Serra-Rocketry/ignitor/(commit log)

2026-09-25 feat(pcb): consolida projetos de ignição THT/SMD e move gerbers para hardware/gerbers
    - Adiciona projetos pcbignicao (THT) e pcbignicao_smd completos
    - Adiciona biblioteca compartilhada hardware/kicad/shared/lib
    - Move gerbers do comando para hardware/gerbers/pcbcomando e remove
    fabricação/*.nc, round-tracks-config e gerbers antigos avulsos
    - Versiona BOM/CPL/posição de fabricação (exceções ao *.csv no .gitignore)
    - Ignora *.bak e *.kicad_prl e deixa de rastrear pcbcomando.kicad_prl
    [alimentacao.kicad_sch, bom.csv, expansao.kicad_sch, interface.kicad_sch, jlcpcb-bom.csv, mcu_esp32.kicad_sch, mcu_pico.kicad_sch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]
2026-09-25 docs(pcb): normaliza títulos e revisão do projeto SMD
    - Sufixo (SMD) nos títulos da raiz e das subfolhas
    - Rev 2.0 e data 2026-09-24 alinhados ao README de fabricação
    - Corrige comentário que citava a placa THT
    - Netlist validado: idêntico antes/depois
    [alimentacao.kicad_sch, expansao.kicad_sch, interface.kicad_sch, mcu_esp32.kicad_sch, pcbignicao_smd.kicad_sch, radio_lora.kicad_sch, saida_ignicao_seguranca.kicad_sch]
2026-09-25 docs(pcb): adiciona sufixo (THT) aos títulos do projeto de ignição
    - Sufixo (THT) nos títulos da raiz e das subfolhas
    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
    [alimentacao.kicad_sch, expansao.kicad_sch, interface.kicad_sch, mcu_pico.kicad_sch, pcbignicao.kicad_sch, radio_lora.kicad_sch, saida_ignicao_seguranca.kicad_sch]
2026-09-25 refactor(pcb): hierarquiza o esquema do comando em subfolhas
    - Divide o esquema plano em Alimentacao, MCU_Pico, Radio_LoRa e Interface
    - Itens movidos por bloco, com offset ancorado na grade de 1,27 mm
    - Rev 1.2 / data 2026-09-25 e títulos nas subfolhas
    - Netlist validado: idêntico antes/depois; ERC mantém os mesmos 6 avisos
    [alimentacao.kicad_sch, interface.kicad_sch, mcu_pico.kicad_sch, pcbcomando.kicad_sch, radio_lora.kicad_sch]
2026-09-25 feat(pcb): reduz vias de costura da ignição THT (rev 1.3)
    - Vias GND: 112 -> 43 (total 124 -> 55), espaçamento ~6-8 mm
    - Zonas refeitas; DRC mantém 0 itens desconectados
    - Corrige título do PCB (estava com o título do comando) e sobe rev/data
    - Gerbers, drill e pacote JLCPCB regenerados; README atualizado
    - Netlist revalidado: idêntico antes/depois
    [alimentacao.kicad_sch, expansao.kicad_sch, interface.kicad_sch, mcu_pico.kicad_sch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]
2026-09-25 feat(pcb): reduz vias de costura da ignição SMD (rev 2.1)
    - Vias GND: 388 -> 101 (total 406 -> 119), espaçamento ~6-8 mm
    - 2 vias de ponte amarram as ilhas de cobre perto de J9/J11
    - DRC: 0 itens desconectados (antes 1, o ilhado documentado no README)
    - Corrige título do PCB e sobe rev/data; gerbers e pacote JLCPCB regenerados
    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
    [alimentacao.kicad_sch, expansao.kicad_sch, interface.kicad_sch, mcu_esp32.kicad_sch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]
2026-09-25 fix(pcb): sincroniza paths de folha dos footprints (THT/SMD)
    - Footprints apontavam para "/" ou UUIDs antigos; agora seguem a hierarquia
    - Reduz avisos de paridade (THT 80->76, SMD 82->75)
    - Sem mudança de cobre/serigrafia: gerbers permanecem válidos
    [pcbignicao.kicad_pcb, pcbignicao_smd.kicad_pcb]
2026-09-25 feat(pcb): padroniza pacote de fabricação do comando (rev 1.2)
    - Gerbers com extensão Protel, drill único e job, como as placas de ignição
    - Remove gerbers antigos (.gbr e drills NPTH/PTH separados) e regenera o zip
    - Cria hardware/gerbers/pcbcomando/README.md
    - Sincroniza paths de folha dos footprints do comando
    - Rev 1.2 / data 2026-09-25 no PCB e nas subfolhas
    - hardware/README.md: pinagem real do comando, da THT e do NodeMCU-32S
    [pcbcomando-B_Cu.gbl, pcbcomando-B_Cu.gbr, pcbcomando-B_Mask.gbs, pcbcomando-B_Silkscreen.gbo, pcbcomando-Edge_Cuts.gm1, pcbcomando-F_Cu.gbr, pcbcomando-F_Cu.gtl, pcbcomando-F_Mask.gts]
2026-09-25 docs: adiciona relatório da revisão de hardware e firmware
    - Consolida os passos 0-3 e 5 executados, com evidências de validação
    - Registra o Passo 4 (comando SMD) como pendente, com plano proposto
    - Documenta a pendência de paridade esquema/PCB (requer update via GUI)
2026-09-25 feat(pcb): elimina vias de costura da ignição SMD (rev 2.2)
    - Remove as 97 vias de costura restantes; o plano GND fecha com 2 vias de ponte
    - Total: 406 -> 24 vias (18 de sinal + 4 GND funcionais + 2 de amarração)
    - DRC: 0 itens desconectados e os mesmos 255 avisos de silk/lib (sem regressão)
    - Gerbers, drill e pacote JLCPCB regenerados; README e relatório atualizados
    [alimentacao.kicad_sch, expansao.kicad_sch, interface.kicad_sch, mcu_esp32.kicad_sch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]
2026-09-26 fix(kicad): corrige versão da biblioteca ignitor
    - A lib usava (version 20260306), do formato de esquema, e não carregava;
    o formato de biblioteca do KiCad 10 usa 20251024
    - Remove o (embedded_fonts no) indevido no nível da biblioteca
    - Elimina os avisos "biblioteca ignitor não encontrada" no ERC/DRC
2026-09-26 refactor(sch): desaninha anotações e zera o ERC da ignição SMD
    - Notas e títulos realocados para áreas livres; caixas coloridas reencaixadas
    - Power flags que sobrepunham U2/U3/J11 movidos com stub e junção (conexão mantida)
    - C1/C2/PWR_FLAG sincronizados com as bibliotecas do sistema
    - ERC: 7 -> 0 avisos; netlist revalidado idêntico
    [alimentacao.kicad_sch, expansao.kicad_sch, interface.kicad_sch, mcu_esp32.kicad_sch, pcbignicao_smd.kicad_sch, radio_lora.kicad_sch, saida_ignicao_seguranca.kicad_sch]
2026-09-26 refactor(sch): desaninha anotações e zera o ERC da ignição THT
    - Power flags sobrepostos movidos com stub e junção (conexão mantida)
    - ERC: 5 -> 0 avisos; netlist revalidado idêntico
    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
    [alimentacao.kicad_sch, expansao.kicad_sch, interface.kicad_sch, mcu_pico.kicad_sch, radio_lora.kicad_sch, saida_ignicao_seguranca.kicad_sch]
2026-09-26 refactor(sch): desaninha anotações e zera o ERC da estação de comando
    - Notas e títulos realocados para áreas livres
    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
    [mcu_pico.kicad_sch, radio_lora.kicad_sch]
2026-09-26 chore(tools): versiona o ferramental de PCB em hardware/tools/kicad
    - 47 scripts Python agrupados em posicionar / rotear / plano-terra /
    acabamento / versao-smd / fabricacao / limpeza / diagnostico
    - README com o que cada um faz e com as armadilhas ja mapeadas
    (limites da API SWIG do pcbnew, Freerouting, export de netlist, etc.)
    Os scripts rodam com o Python embutido do KiCad 10 e nao exigem o KiCad
    aberto. Sem eles o pipeline de posicionamento/roteamento nao e reproduzivel.
2026-09-26 fix(pcb): corrige isolamento abaixo do minimo da JLCPCB no comando
    O DRC acusava 10 erros na placa de comando:
    - 7 de isolamento entre 0,1017 e 0,1200 mm (minimo da JLCPCB: 0,127 mm),
    todos na faixa entre a coluna de pads do Pico (x=132,63) e a borda
    esquerda (x=130,02) — só 2,6 mm de espaco
    - 3 de cobre-borda: vias de costura a 0,31 mm da borda (recomendado 0,5 mm)
    Correcao: os 7 trechos apertados foram afinados apenas o necessario
    (0,40 -> 0,30..0,32 e 0,50 -> 0,44), preservando 0,4/0,5 na maior parte do
    roteamento; as 3 vias foram afastadas 0,24 mm para dentro.
    Nenhuma conexao foi criada, removida ou alterada: só largura e posicao de
    segmentos existentes. DRC: 10 erros -> 0, com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
    [pcbcomando.kicad_pcb]
2026-09-28 feat(tools): adiciona swap_fp_pcb.py para trocar footprints na PCB
2026-09-28 fix(tools): trata vias existentes como furos no stitch de terra
2026-09-28 feat(pcb): troca U2/U3 de SOP-4 para DIP-4 na ignição SMD (rerroteio pendente)
    [pcbignicao_smd.kicad_pcb, saida_ignicao_seguranca.kicad_sch]
2026-09-28 feat(fab): organiza pacote JLCPCB da ignição SMD em subpasta jlcpcb
    [jlcpcb-bom.csv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]
2026-09-28 docs: atualiza READMEs para a troca U2/U3 (DIP-4) e pastas de hardware
